PR77/A500_ACCEL_RAM_IDE-Rev-2/Images/HardwareWithoutIDE.JPG

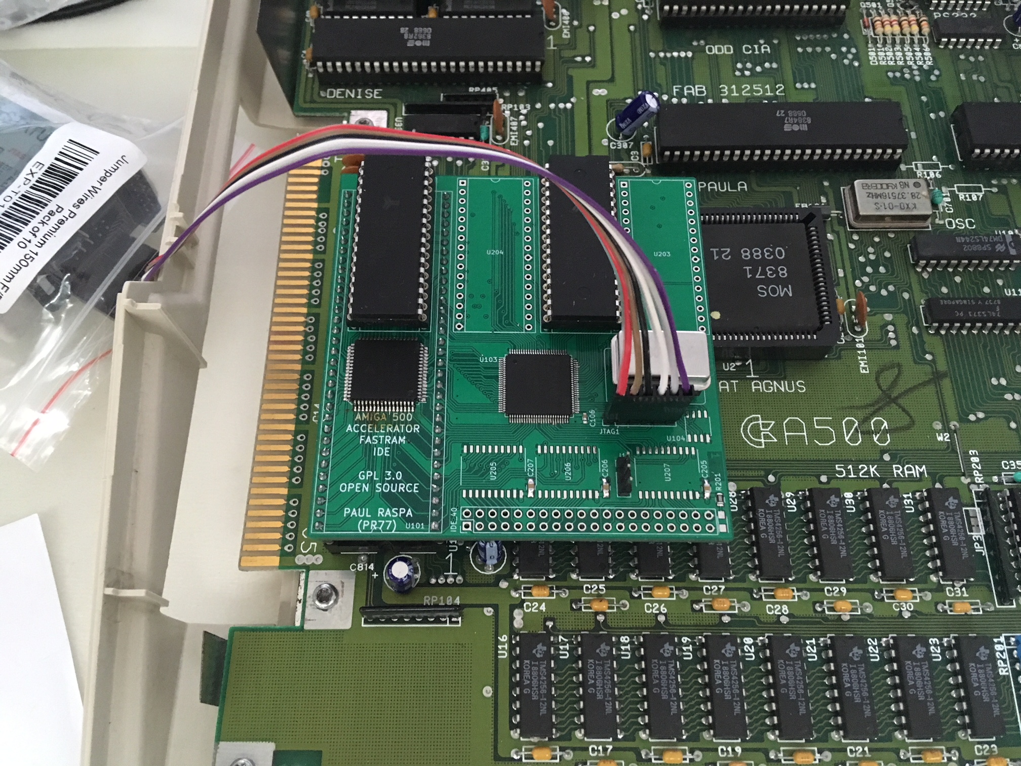
Images/HardwareWithoutIDE.JPG
