PR77/A500_ACCEL_RAM_IDE-Rev-2/(threads)

Thread 1 (2019-08-15):

how stable is it?

tehKaiN, 2019-08-15:
I'm planning a redesign of Protein turbocard since I already bought cplds but have faulty batch of pcbs and people who successfully built them are complaining about its stability anyway.

So I'm wondering if this project's verilog code and schematic is a good reference for such redesign or are there some bugs which I should have in mind while reading sources?

Anyway, you're doing a very good work with keeping project files open, I really thank you for that. It's a priceless reference for me!

PR77, 2019-08-16:
Stability when used standalone is good. I am working with other people in the community to refactor the Verilog to address issues when used with other Hardware; for example my Reloactor with Flash KS support.

Please keep in mind this design currently does not support Autoboot and there are several design changes pending (refer to main README.md).

Closed 2019-08-19.

Thread 2 (2020-10-26):

Can this board boot without ram ?

Twisty59, 2020-10-26:
Hello,

I try to make this project for my A500, I did solder everything except the RAM & IDE parts but I get a black screen on DiagROM.
Can it boot without any ram chip or something is wrong with my soldering ?

Thanks you

PR77, 2020-10-26:
Hello,

With DiagROM, RAM is not necessary and the Amiga should boot without issue. When using a real Kickstart ROM, you would enter a reset loop if the RAM is not fitted. A few points to check;

On the Amiga 68000 CPU connections, can you see (assuming CPLD is programmed and you have thoroughly checked your solder joints);

. /AS toggling?
./BERR or /HALT active?
.E CLK?

Twisty59, 2020-10-26:
Hey,

Thanks you for your reply, yes the CPLD is programmed and verfied, this part should be good. I did reflow solder joints on the CPU and still get a black screen.

I'm really amateur in building a project like this, its is possible to check AS, BERR, CLK just with a multimeter or I will need an oscilloscope ?

PR77, 2020-10-26:
Hello,

You really need a scope to check the behaviour of the signals changing state, however a Multimeter would work for some basic debugging.

You could use the Multimeter to determine if the /BERR and /HALT signals are active (active low so you should see a logic HIGH is they are not active). As for the /AS or E CLK, as they should be constantly changing the Multimeter might show a changing voltage or an average voltage. If it is stuck on logic LOW or HIGH then you know you have an issue.

You could send some pictures?

Twisty59, 2020-10-26:
Thanks you for your help, I'll try to check that then.

Some pictures of my board
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

Twisty59, 2020-10-26:
I've tested few point with multimeter

.E CLK have a constant 2.2v but I can't see the 30mhz signal with the multimeter
/HALT stay HIGH at 4,7v constant
/BERR stay HIGH at 5,1v constant

Looks like something is wrong..

PR77, 2020-10-26:
Hello,

From the photos, some of the solder joints look a bit suspect. Have you checked for shorts between neighbouring pins on the CPLD and CPU? You can probe most of the signals on the 68000 DIP socket to make it simpler.

Twisty59, 2020-10-26:
I did check every shorts between pins on the 68SEC000 but not the CPLD, i'll take a look tomorrow and maybe try to build a second board.

Twisty59, 2020-11-02:
Hello,

I build my second board today and I've got the exact same problem, black screen on diagrom.
I did check solder joints with microspoe, check short on each pins and reflow everything but always same problem.

PR77, 2020-11-02:
Hello,

Do you have serial output from DiagROM? Additionally, are you seeing the initial screen flashes? What XTAL frequency are you using? Can you use 10MHz or 16MHz as a test?

Twisty59, 2020-11-02:
No screens flashes or power led blink, will try to see if serial say something.
I did try with a 30Mhz & 40Mhz, maybe thats too much.

PR77, 2020-11-02:
Hello,

I'm currently working on an Amiga 600 version of the accelerator and I am finding the CPU isn't too happy over 30MHz. Try a lower frequency just to make sure the CPU isn't locking-up if the CLK is too high. I see you have the accelerator on a relocator board, if you replace the accelerator card with the plan CPU does it then work?

PR77, 2021-05-12:
Hi there,

That is great news. The verilog actually only supports 1MEG. The hardware will support 2, however I never got around to updating it. When I get some time back I can try to make the updates- I actually have many “improvements” I would like to make.

Twisty59, 2021-05-12:
Hi,

Thanks you so much for making this board real, it is very stable at 30Mhz, not a single crash.
Is it possible to get the correct ide.device for the IDE support ? Or maybe an .adf for booting because i'm a bit lost with this.

Thanks you :)

Twisty59, 2021-05-16:
Hello,

I have manage to get some sign of life of my IDE to CF Adaptater by using AddHD.
But something is wrong, AddHD Driveinfo show my CF with 80Go and its a 2Go.
Wich version of ide.device you was using for this board ?

Thanks for help :)

PR77, 2021-05-22:
Hi There,

I created a ROM image with version 2.58 of ide.device using Remus. You can find version 2.59 here - [https://gitlab.com/MHeinrichs/AIDE/-/tree/master/device/new-version].

Twisty59, 2021-05-22:
Hey,

I'll try to build one if it can autoboot with the ide.device and bootide.device but I have few questions.
Did you remove the scsi.device from previous rom ? base address for this board is $F20000 ?

Thanks :)

PR77, 2021-05-22:
Hi There,

Yes, I had to remove scsi.device to make the other components fit. Base address of the IDE interface is 0xEF0000, which is the default for the ide.device.

Twisty59, 2021-06-08:
Hello,

I have made my custom rom including ide.device and bootide.device and its still doesn't work.. my amiga boot and the HDD led stay light up but it doesn't boot on IDE.
I did try my rom with a simple AIDE board and its work great so I know my problem doesn't come from software part.

I have made your board twice and I do have this problem on both of them. So I have a few question :
I'm using 74HCT245D instead of 74HCT245, can it be the reason ?
Or maybe the CPLD firmware is not up to date on the github ?

I'm questioning about the firmware because both of my boards have a difference in terms of Dhrystones :
30Mhz Oscillator:
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With a 36Mhz Oscillator:
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

At 36mhz i'm far away from you at 30mhz

Thanks you for your help 😄

PR77, 2021-06-08:
Hi There,

I will try to summarise your questions with my feedback;

Q: I have made my custom rom including ide.device and bootide.device and its still doesn't work. What could it be?
A: When you boot via floppy, is the HDD visible within WB when connected to the accelerator? Using HDToolBox, you can try to change the DEVICE in the Icon ToolTypes to ide.device (from scsi.device) to check if the HDD is visible. Are you powering the HDD via PIN 20 on the IDE connector? On the current HW, PIN 20 is not routed to VCC.

Q: Could 74HCT245D be the reason?
A: No, I am using these parts as well.

Q: JED file version out of date?
A: I just rebuilt the JED and it is the same as the version in the repo.

Q: Why are the Dhrystones different?
A: In newer versions of the Verilog I inserted 2 WS into the RAM access to help with some other changes I was doing. Refer to line #402. I've created a JED without the WS for you to try (untested as I don't have my A500 setup at the moment).

P.S., if you are on Discord you can find me on "Official Commodore Amiga" or "Retro Tinkering".

Closed 2021-08-29.

Thread 4 (2021-03-17):

AT25 version ?

nobodyisinocent, 2021-03-17:
Hello,

Thanks a lot for your very cool project.
I'd like to know the exact reference of AT25 you used onto the board.
There are different memory capacities available.

Thank you very much!

Best regards,
Franck

PR77, 2021-03-18:
Hi There,

Just FYI - please see point Known Issues (in the main README.md) #2, "Correct SPI Flash footprint. Or considering to remove it as I see no immediate benefit.". You can use any SPI Flash here however I have not finished the amiga side SW to use it. This would need to be done.

When I get around to updating this PCB (there are several improvements I want to do) I will actually remove the SPI Flash.

nobodyisinocent, 2021-03-25:
Hi,

Thanks a lot for your answer !
I'll check the Know Issues link.

Thank you also for sharing your work !
Franck

Closed 2021-03-26.

Thread 5 (2021-09-30):

How to boot from HDD/CF

retroman75, 2021-09-30:
Hi there ,
I'm new in Amiga word , I have build one for my safe and struggling how to boot A500 from it ? Is is possible without FDD boot disk ? If kernel mod is needed by uploading IDE.devide lib. is necessary then how to do it ?  . Anybody can help ?
Thank you !

PR77, 2021-09-30:
Hi there, currently kernel mod is needed if you don't want to use a bootdisk. Have a look here for details;

#2

retroman75, 2021-10-01:
Could you please give little more info about that kernel mod ? My understanding is that I will have to add ide.device lib. to my existing ROM image ?... if so , how to do it ? any software is needed ? . Please help :)
Thank you

Twisty59, 2021-10-06:
Hello,

You need to have a least the ide.device working on $EF0000 to boot. You can just using a floppy disk for booting.
If you want to make it autoboot you need to make a custom rom with ide.device AND bootide.device, you will need to remove scsi.device from the original rom.
I have made a custom rom 3.1 and autoboot if working very well on this board ! :)

retroman75, 2021-10-07:
Thanks for fast replay , but is there any software to manipulate Kernal image  ?

Mingo12, 2022-07-29:
@Twisty59
Can you please give me more information about creating the kickstart? I removed scsi.device and added ide.device and bootide.device with Remus. With the patched Kickstart 3.1, CF won't boot and floppy disks won't boot either.

Mingo12, 2022-08-02:
In the meantime I got a patched ROM from someone. Thank you anyway!

Closed 2022-03-28.

Thread 7 (2022-08-08):

Gerber.zip and KiCAD files do not match

DrDidlittle, 2022-08-08:
The layout of the KiCAD files in ./Hardware and the Gerbers in ./Hardware/Gerbers.zip do not match.

PR77, 2022-08-08:
KiCAD files have been corrected. Thanks for pointing this out. The Gerbers were (and still are) correct.

Closed 2022-08-08.

Thread 8 (2022-10-14):

RAM upgrade

FeelBGood, 2022-10-14:
Hi,

Good day.

I have seen your really good job concerning this accelerator board for the AMIGA.

I just wonder if it's possible to add more RAM up to :

4x 1mb SRAM = 4 mb

AS6C1008-55PCN
SRAM 1Mb, 2.7V-5.5V, 55ns 128K x 8 Asynch SRAM

4x 4mb SRAM = 16 mb

AS6C4008-55PCN
SRAM 4M, 2.7-5.5V, 55ns 512K x 8 Asynch SRAM

Is there something that needs to be changed in the program?

Memory address?

Thanks in advance for your answers.

PR77, 2022-10-28:
Hi There,

Please don't confuse 1 MB with 1Mb. 1 Megabit verses 1 Megabyte. AS6C4008-55PCN is what I am currently using and 4 devices offers 2 Megabytes maximum expansion. RAM chips could be piggy-backed however the CPLD firmware would need to be modified to support a larger addressed space.

Thread 9 (2024-07-31):

Looking for information

jdwininger, 2024-07-31:
Hey there, I recently came into possession of a V2 board. I've been looking to play around with it but there isn't a lot of data about it online. I was looking to find information on changing the clock speed and information about the IDE controller, in particular what ROM version is needed to support it. I've been googling for a couple of days and not turned up any useful information.

thanks.

PR77, 2024-07-31:
Hey, yes I agree these details are a bit limited. I used Remus to create a custom image based on Kick 3.1 and 2.58 (I think) of the IDE driver. In the next days I’ll create a MD document with the details.

PR77, 2024-07-31:
BTW, changing the clock speed is as simple as changing the value of the XTAL oscillator. Mine does not stay stable past 40Mhz due to both the CPU and RAM timings (with 0 wait states). I find 40Mhz enough and it satisfies my childhood dream of building my own accelerator for the A500. 😉

If you understand Verilog, then I suggest having a look in there to get a better idea.

PR77, 2024-08-10:
Hey there, I created a simple guide to create a custom kickstart, have a look at the KICKSTART.md in the repo root.

Good luck - reach out if you need help!

jdwininger, 2024-08-10:
Thank you for all the information. I didn’t expect so much. Thank you again.

Closed 2024-08-10.

Thread 11 (2025-04-15):

SPI U104 how to use program etc

Mavideoart, 2025-04-15:
Hello
Thank you for your wonderful build project and commitment to the Amiga community.  I've built your board and would like to understand the SPI Chip on U104.
Is this chip operational and can I program it to take advantage of the full features of A500 accel ram IDE Rev-2?

Some more information would be very helpful.

Thankyou
Michael

Mavideoart, 2025-04-21:
Thanks for the info.
