PR77/A500_ACCEL_RAM_IDE-Rev-2/Hardware/A500_ACCEL_RAM_IDE.pdf

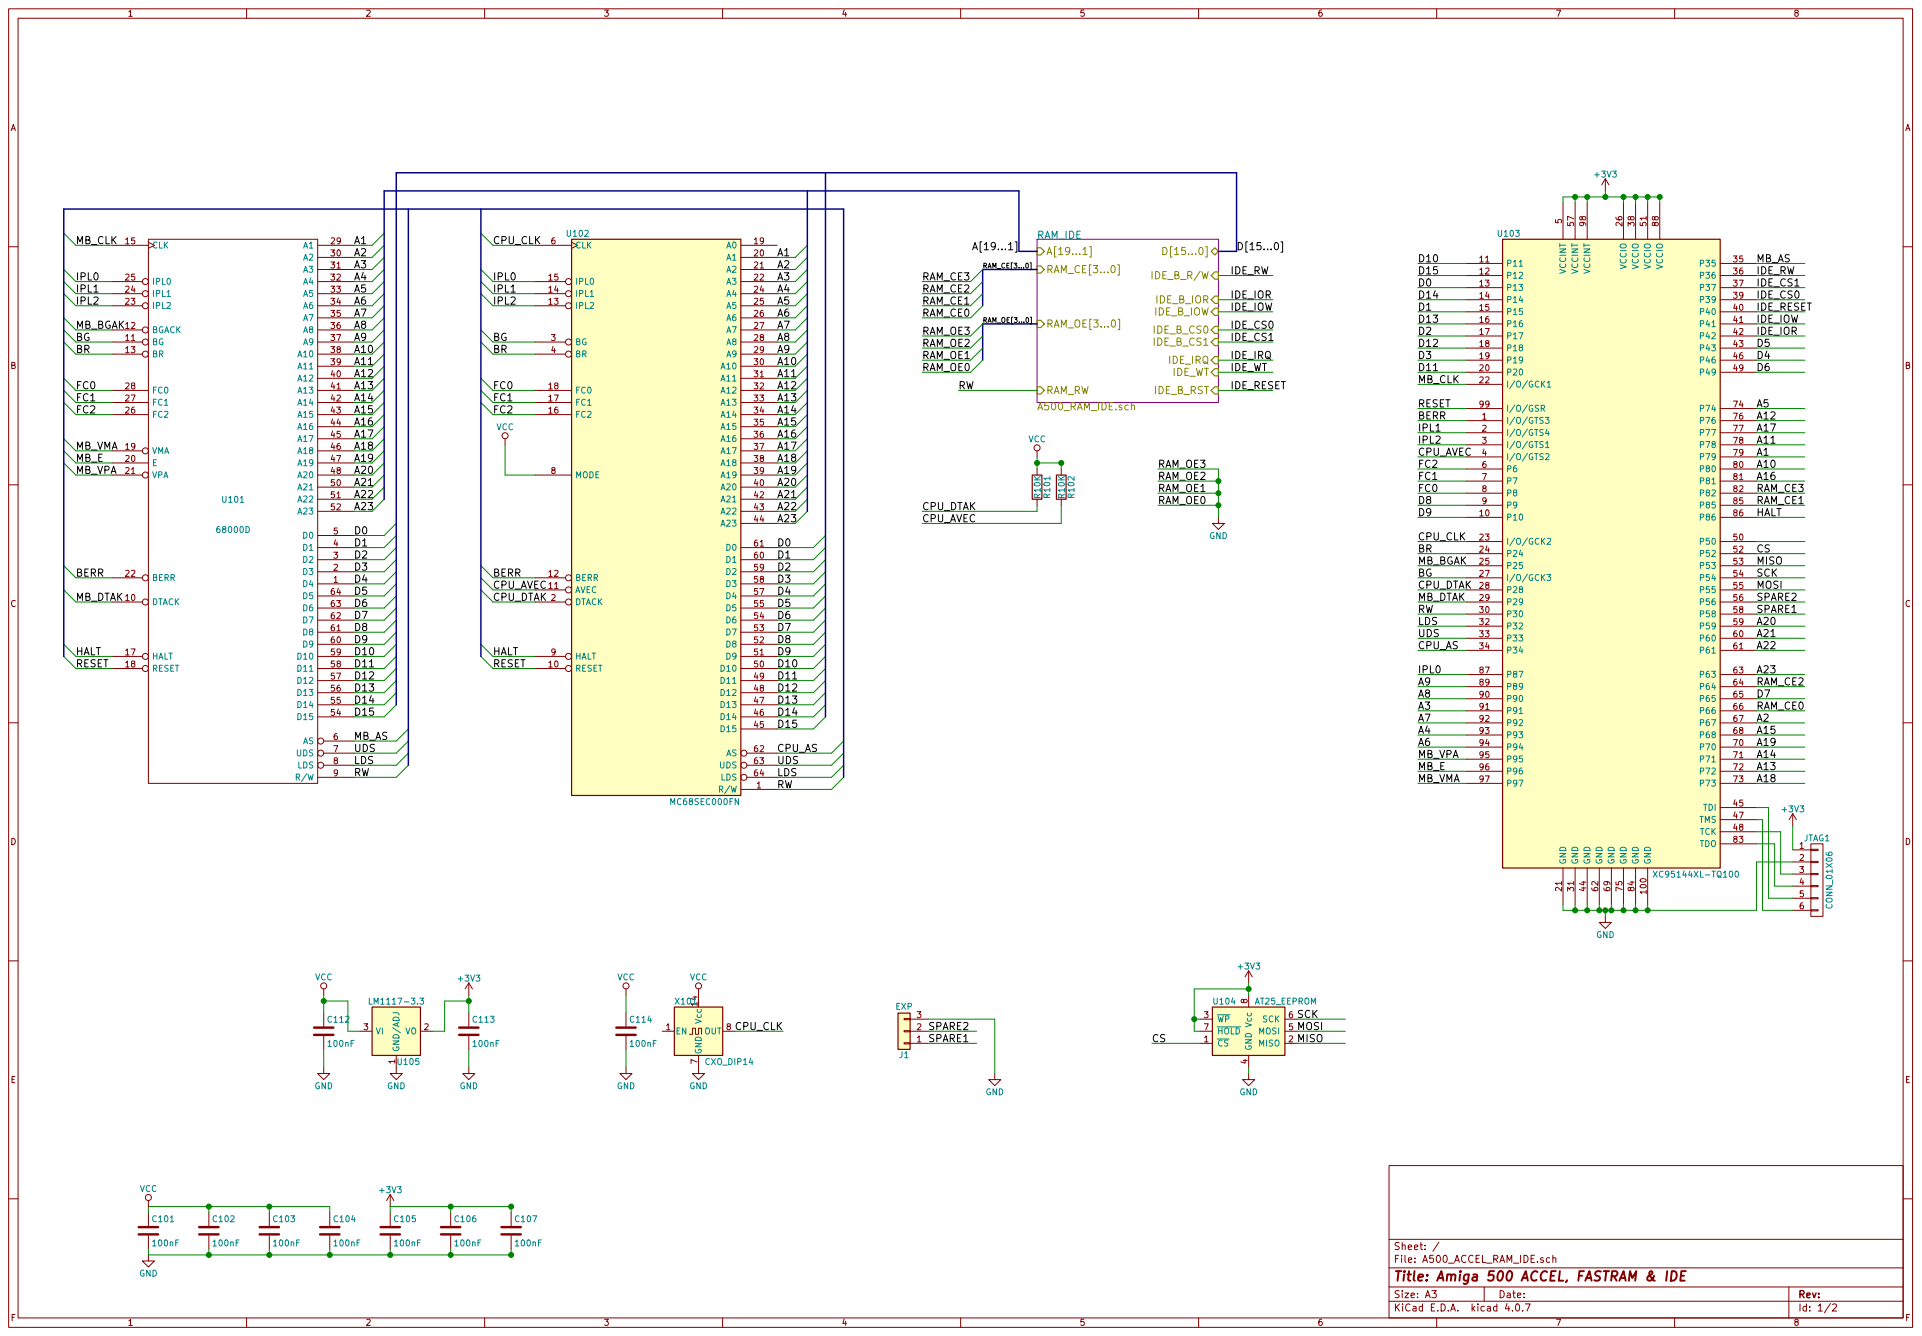
[picture p12: page 1]

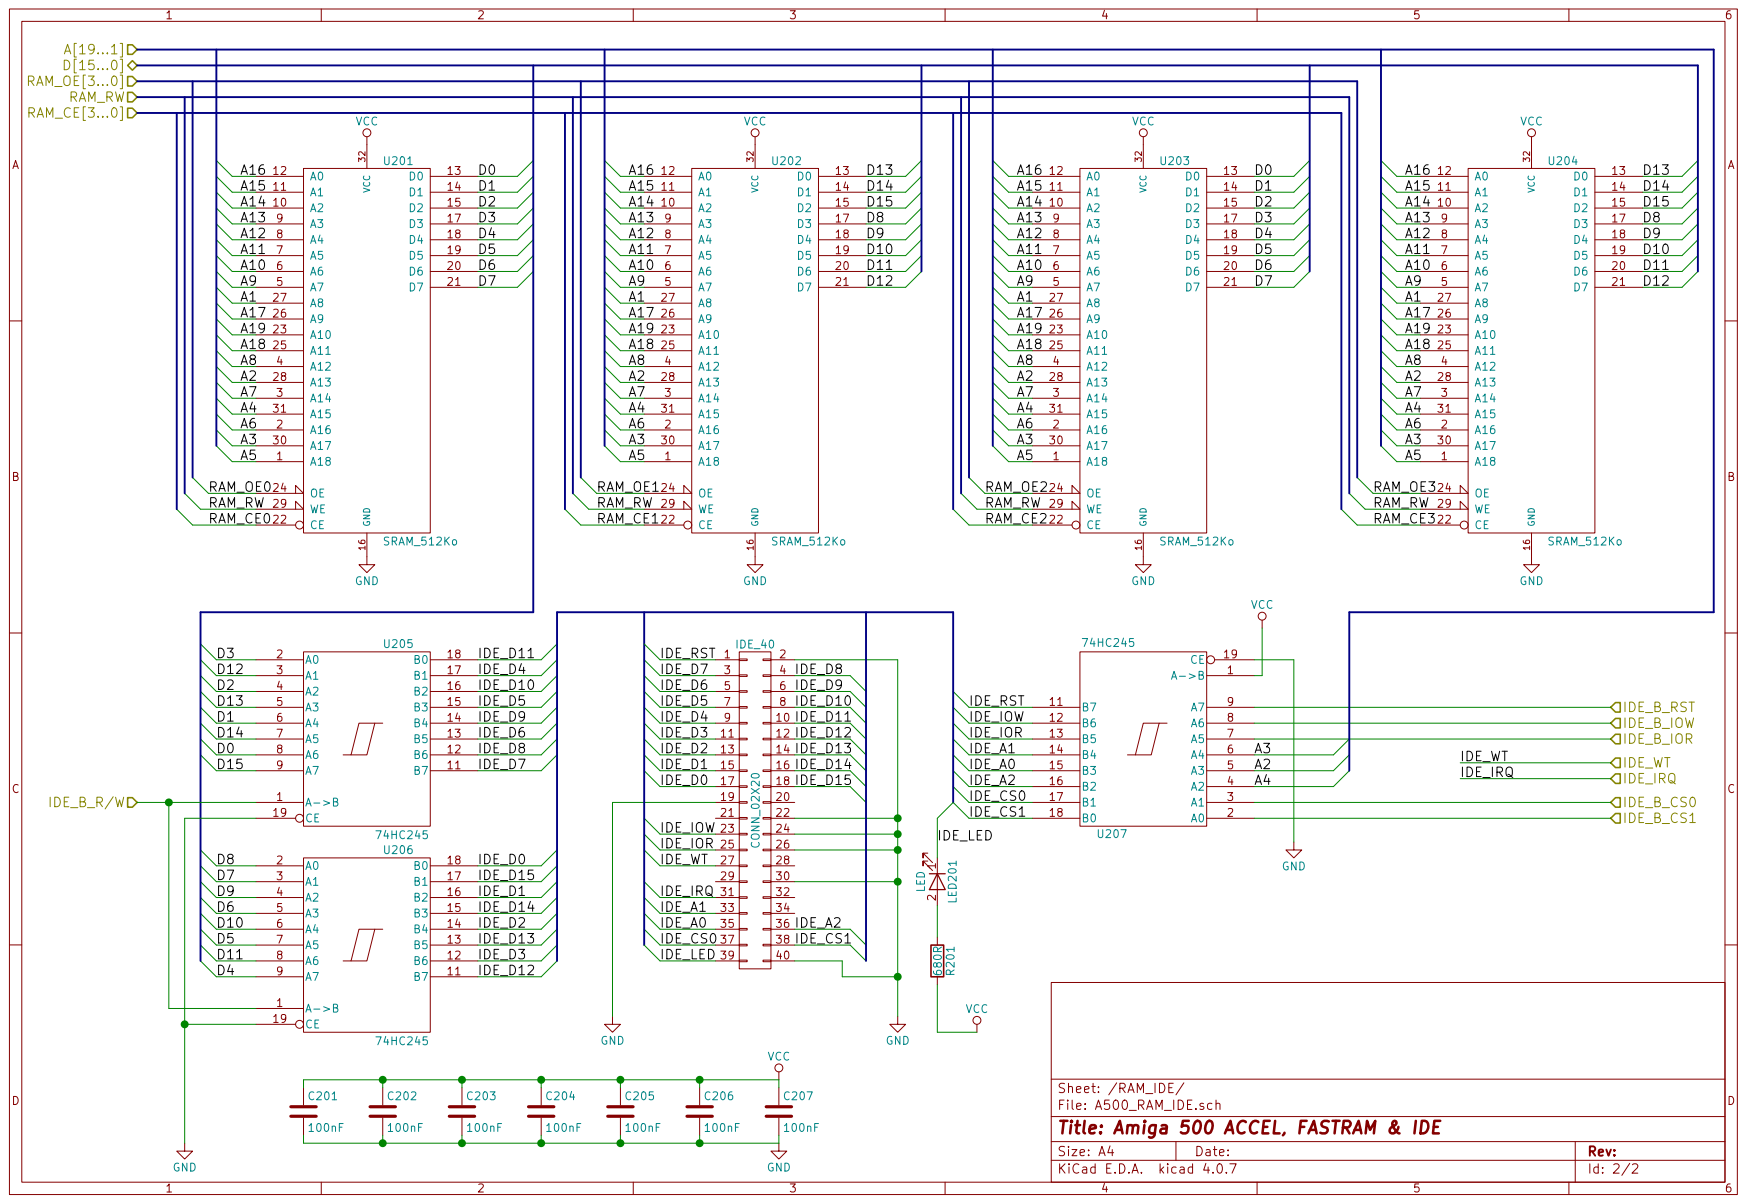
[picture p13: page 2]
