PR77/A500_ACCEL_RAM_IDE-Rev-2/(commit log)

2018-08-20 Updates for chained AutoConfig requests
2018-08-20 Updated EAB link to entire thread
2018-08-21 IDE /CS correction
    Thanks TerribleFire for pointing out the IDE /CS[1:0] bug.
    [ACCEL_RAM_IDE.v]
2018-09-08 All memory (and device) accesses now qualified against /DS
2018-12-29 Updates
    Fixed some bugs AUTOCONFIG logic and added SPI support.
    [ACCEL_RAM_IDE.v]
2018-12-31 Added
    Added IOTest and SPITest to exercise the IO and SPI Interfaces. Not yet fully complete and tested.
2019-05-22 Updates
    Added BOM.
2021-08-29 Updates
    Code clean up and bug fix improvements.
    [ACCEL_RAM_IDE.v]
